SPIRIT-org/USB-test/README.md

# This is a sub-project to test the USB 3.1 circuit.
