SPIRIT-org/USB-test/USB-rev-2/USB-rev-2.kicad_pcb

## KiCad design USB-rev-2/USB-rev-2.kicad_pcb (2026-09-09)

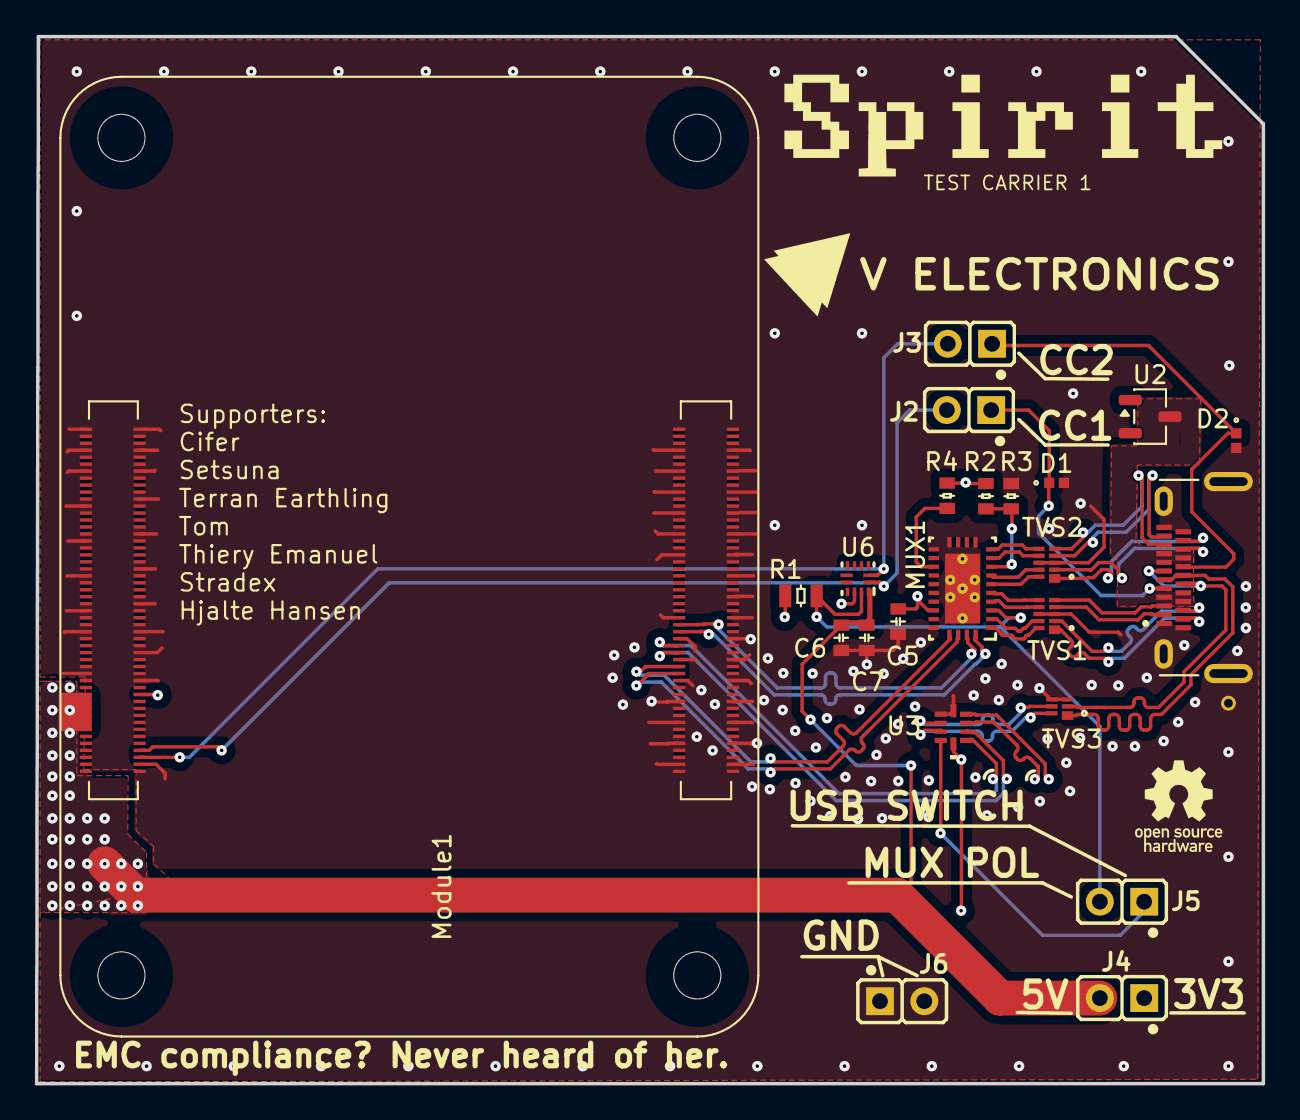
[picture p1: board USB-rev-2.kicad_pcb from above]

Board: 4 copper layers, 70.3 x 60.0 mm, 23 parts (0 on the bottom side), 40 nets.

Parts:
C5: 0.1uF; 0603-capacitor
C6: 100nF; 0603-capacitor
C7: 22uF; 0603-capacitor
D1, D2: TPD1E05U06DPYR; TPD1E05U-SON65P60X100X45-2N
J1: USBC-4-0-CX90MW9-24P1; USB-4-0-HIROSE_CX90MW9-24P1
J2, J3, J4, J5, J6: COMATEL_385.0358.1.02.400
MUX1: MUX HD3SS460RHRR; USB-MUX-RHR0028A
Module1: ComputeModule5-CM5; Raspberry-Pi-5-Compute-Module
R1: 1K-05W-0805; 0805-resistor
R2, R3, R4: 10kΩ; 0603-resistor
TVS1, TVS2: TVS-choke-2-pair-EMI8142MUTAG; 2-channel-TVS-chokeXDFN10_2P2X1P3_ONS
TVS3: 2 Line Common Mode Choke with ESD 100mA DCR 6Ohm; 1-channel-TVS-choke-XDFN6_1P2X1P2_ONS
U2: ESDA25L; SOT-23-3
U3: USB SWITCH 2CHANNEL TS3USB221AQRSERQ1; USB-SWITCH-2CHANNEL-TS3USB221AQRSERQ1
U6: usb-polarity-TUSB321RWBR; polarity-usb-TUSB321RWBR

Connections:
3V3B: C5.1, J4.1, MUX1.22 (VCC), Module1.78 (GPIO_VREF(1.8v/3.3v_Input)), R1.2, R2.2, R4.2, U3.10 (VCC)
5V: C6.1, C7.1, J4.2, Module1.77 (+5v_(Input)), Module1.79 (+5v_(Input)), Module1.81 (+5v_(Input)), Module1.83 (+5v_(Input)), Module1.85 (+5v_(Input)), Module1.87 (+5v_(Input)), U6.12 (VDD)
CC1: D1.1, J1.A5 (CC1), J2.1
CC1-jumpered: J2.2, Module1.94 (CC1), U6.1 (CC1)
CC2: D2.1, J1.B5 (CC2), J3.1
CC2-jumpered: J3.2, Module1.96 (CC2), U6.2 (CC2)
D+: J1.A6 (D1+), J1.B6 (D2+), TVS3.1 (D+IN)
D-: J1.A7 (D1-), J1.B7 (D2-), TVS3.2 (D-IN)
DSI1_D2_N: Module1.133 (MIPI0_D2_N), Module1.193 (MIPI1_D2_N)
DSI1_D2_P: Module1.135 (MIPI0_D2_P), Module1.195 (MIPI1_D2_P)
Df+: TVS3.6 (D+OUT), U3.8 (D+)
Df-: TVS3.5 (D-OUT), U3.7 (D-)
GND: C5.2, C6.2, C7.2, D1.2, D2.2, J1.A1 (GND_A), J1.A12 (GND_A__1), J1.B1 (GND_B), J1.B12 (GND_B__1), J1.SH1 (SHIELD), J1.SH2 (SHIELD__1), J1.SH3 (SHIELD__2), J1.SH4 (SHIELD__3), J6.1, J6.2, MUX1.29 (PAD_GND), Module1.1 (GND), Module1.2 (GND), Module1.7 (GND), Module1.8 (GND), Module1.13 (GND), Module1.14 (GND), Module1.22 (GND), Module1.23 (GND), Module1.32 (GND), Module1.33 (GND), Module1.42 (GND), Module1.43 (GND), Module1.52 (GND), Module1.53 (GND), Module1.59 (GND), Module1.60 (GND), Module1.66 (GND), Module1.71 (GND), Module1.74 (GND), Module1.98 (GND), Module1.107 (GND), Module1.108 (GND), Module1.113 (GND), Module1.114 (GND), Module1.119 (GND), Module1.120 (GND), Module1.125 (GND), Module1.126 (GND), Module1.131 (GND), Module1.132 (GND), Module1.137 (GND), Module1.138 (GND), Module1.144 (GND), Module1.150 (GND), Module1.155 (GND), Module1.156 (GND), Module1.161 (GND), Module1.162 (GND), Module1.167 (GND), Module1.168 (GND), Module1.173 (GND), Module1.174 (GND), Module1.179 (GND), Module1.180 (GND), Module1.185 (GND), Module1.186 (GND), Module1.191 (GND), Module1.192 (GND), Module1.197 (GND), Module1.198 (GND), R3.2, TVS1.3 (GND), TVS1.8 (GND), TVS2.3 (GND), TVS2.8 (GND), TVS3.3 (GND), TVS3.4 (GND), U2.2, U3.5 (GND), U3.6 (~OE), U6.10 (GND)
MUX POL: J5.2, MUX1.3 (POL), R1.1, U6.11 (DIR)
unnamed: MUX1.8 (AMSEL), R2.1, R3.1
unnamed: MUX1.17 (EN), R4.1
RX1+: J1.B11 (RX1+), TVS1.1 (IN_1+)
RX1-: J1.B10 (RX1-), TVS1.2 (IN_1−)
RX1f+: MUX1.1 (CRX1P), TVS1.10 (OUT_1+)
RX1f-: MUX1.2 (CRX1N), TVS1.9 (OUT_1-)
RX2+: J1.A11 (RX2+), TVS2.4 (IN_2+)
RX2-: J1.A10 (RX2-), TVS2.5 (IN_2-)
RX2f+: MUX1.9 (CRX2P), TVS2.7 (OUT_2+)
RX2f-: MUX1.10 (CRX2N), TVS2.6 (OUT_2-)
SSTR2+: MUX1.28 (SSRXP), Module1.159 (USB3-1-RX_P)
SSTR2-: MUX1.27 (SSRXN), Module1.157 (USB3-1-RX_N)
SSTX2+: MUX1.26 (SSTXP), Module1.171 (USB3-1-TX_P)
SSTX2-: MUX1.25 (SSTXN), Module1.169 (USB3-1-TX_N)
SYS D+: Module1.163 (USB3-1-D_P), U3.1 (1D+)
SYS D-: Module1.165 (USB3-1-D_N), U3.2 (1D-)
TX1+: J1.A2 (TX1+), TVS1.4 (IN_2+)
TX1-: J1.A3 (TX1-), TVS1.5 (IN_2-)
TX1f+: MUX1.4 (CTX1P), TVS1.7 (OUT_2+)
TX1f-: MUX1.5 (CTX1N), TVS1.6 (OUT_2-)
TX2+: J1.B2 (TX2+), TVS2.1 (IN_1+)
TX2-: J1.B3 (TX2-), TVS2.2 (IN_1−)
TX2f+: MUX1.6 (CTX2P), TVS2.10 (OUT_1+)
TX2f-: MUX1.7 (CTX2N), TVS2.9 (OUT_1-)
USB SWITCH: J5.1, U3.9 (S)
USBC POW: J1.A4 (VBUS_A), J1.A9 (VBUS_A__1), J1.B4 (VBUS_B), J1.B9 (VBUS_B__1), U2.3
