SPIRIT-org/USB-test/problems.md

# REV 1 PROBLEMS

- [x] diff pair vias too close to eachother (min copper to copper manufacturability for PCBWay is 0.1mm)

- [x] slightly wrong spacing on some diff pairs, should be 0.2mm. Allowable spacings for +/-10% tolerance are ~0.16mm-0.25mm

- [x] vias too small (expensive), drill hole should be 0.5mm larger. Then annular ring size should be adjusted.
>Drill Sizes (CNC)	drill Sizes (CNC) 0.15-6.0mm Min drill size is 0.15mm, max drill is 6.0mm.
>Any holes greater than 6mm or smaller than 0.2mm will be subject to extra charges.
>
>Min Width of Annular Ring	Min Width of Annular Ring 0.15mm(6mil) For pads with vias in the middle,
>Min width for Annular Ring is 0.15mm(6mil).

- [x] increase clearance from copper pour to signal traces

- [x] diff pairs should have a copper plane underneath

- [x] remember about tented vias

# REV 2 PROBLEMS

- [ ] type C socket can't be mounted because there is no clearance for the
recess.

- [ ] BOM states 1x 100 pin Amphenol sockets, actually 2 are needed
per board

- [ ] `GPIO_VREF` should be connected to `CM5_3.3V` instead of `3V3B`
