SPIRIT-org/USB-test/(commit log)

2026-07-25 added TVS protection and filtering to CC lines
    [USB.kicad_pcb, USB.kicad_sch]
2026-07-27 fix TVS protection on CC lines
    [USB.kicad_pcb, USB.kicad_sch]
2026-07-27 add lab power input headers
    [USB.kicad_pcb, USB.kicad_sch]
2026-07-27 add copper pours
    [USB.kicad_pcb]
2026-07-27 connect VBUS to 25V TVS and CC to CM5 for tests
    [USB.kicad_pcb, USB.kicad_sch]
2026-07-27 make vias under type c socket tented and add fab note
    [USB.kicad_pcb]
2026-07-27 add test points for USB SWITCH and MUX POL
    [USB.kicad_pcb, USB.kicad_sch]
2026-07-27 connect test points and connect CM5 to plane
    [USB.kicad_pcb, USB.kicad_sch]
2026-07-27 actually connect the test points (DUMBASS)
    [USB.kicad_pcb]
2026-07-27 stitching vias along SS lines
    [USB.kicad_pcb, USB.kicad_sch]
2026-07-27 tune and stitch d+,d- lines, connect AGND of type c socket to GND
    [USB.kicad_pcb, USB.kicad_sch]
2026-07-27 tent stitching vias under type c socket
    [USB.kicad_pcb]
2026-07-27 add GND test point
    [USB.kicad_pcb, USB.kicad_sch]
2026-07-27 increase via annular ring size for PCBWAY manufacturing
    [USB.kicad_pcb]
2026-07-27 fix some DRC issues
    [USB.kicad_pcb]
2026-08-03 add patreon supporters names
    [USB.kicad_pcb]
2026-08-14 engi 2026-08-13 voicechat review
    [USB.kicad_pcb, USB.kicad_sch]
2026-08-15 add packaging info, remove bad fields, format BOM for PCBWAY
    [USB.kicad_pcb, USB.kicad_sch]
2026-08-15 production files for PCBWAY
    [USB.kicad_pcb_bom.csv, USB.kicad_pcb_positions.csv]
2026-08-27 revision 2
    [USB-rev-2.kicad_pcb, USB-rev-2.kicad_sch, USB.csv, USB.kicad_pcb, USB.kicad_pcb_bom.csv, USB.kicad_pcb_positions.csv, USB.kicad_sch]
2026-09-01 routing progress
    [USB-rev-2.kicad_pcb]
2026-09-02 routing completeish need DRC
    [USB-rev-2.kicad_pcb]
2026-09-02 fix stuff pointed out by DRC
    [USB-rev-2.kicad_pcb]
2026-09-02 production files (+minor fix)
    [USB-rev-2.kicad_pcb, USB-rev-2.kicad_pcb_bom.csv, USB-rev-2.kicad_pcb_positions.csv]
